alhusseingamal/r2sdf-fft/rtl/complex_adder.v

module complex_adder #(parameter W = 16) (
    input signed [W-1:0] a_real, a_imag,
    input signed [W-1:0] b_real, b_imag,
    output wire signed [W-1:0] out_real, out_imag
);

wire signed [W:0] sum_real, sum_imag;

// apply round half-up scheme
assign sum_real = a_real + b_real + 1;
assign sum_imag = a_imag + b_imag + 1;

// shift right by 1 to discard the LSB and restore the output in W-length format
assign out_real = sum_real[W:1];
assign out_imag = sum_imag[W:1];

endmodule
