alhusseingamal/r2sdf-fft/(commit log)

2026-07-29 First Commit: project working but missing final touches
    [butterfly.v, circular_buffer.v, complex_adder.v, complex_multiplier.v, complex_subtractor.v]
2026-09-21 by and large done!
    [metrics.csv]
